CharlieYu4994/superdial/SuperDial电机旋钮屏V2_Bom.xlsx

Sheet: 元器件
SuperDial电机旋钮屏V2物料清单（元器件）
主控板 |  |  |  |  |  |  | 备注
序号 | 数量 | 名称 | 丝印 | 封装 | 值 | 立创链接
1 | 1 | KT-0603R | 3.3 | LED0603-R-RD |  | C2286
2 | 1 | HX25003-2A | B+ GND | CONN-TH_2P-P2.50_HX25003-2A |  | C442299
3 | 3 | CL10A226MQ8NRNC | C1,C6,C8 | C0603 | 22uF | C59461
4 | 5 | CC0603KRX7R9BB104 | C2,C5,C10,C11,C12 | C0603 | 100nF | C14663
5 | 4 | CL21A226MAQNNNE_C45783 | C3,C4,C7,C9 | C0805 | 22uF | C45783 | 耐压25V
6 | 1 | HC-0.8-8PWT | CN2 | CONN-SMD_8P-P0.80_HCTL_HC-0.8-8PWT |  | C2845349
7 | 1 | SWPA6045S100MT | L1 | IND-SMD_L6.0-W6.0_SWPA6045S | 10uH | C79272
8 | 1 | MWSA0402S-1R0MT | L2 | IND-SMD_L4.4-W4.2 | 1uH | C408332
9 | 8 | WS2812B-Mini_C527089 | LED1-LED9 | LED-SMD_4P-L3.5-W3.5-TL_WS2812B |  | C527089 | 3535，可不焊
10 | 8 | 焊盘 | P1,P2,P3,P4,P5,P6,P7,P8 | 焊盘 |  |  | 无需买
11 | 2 | AP2300 | Q1,Q2 | SOT-23-3_L2.9-W1.3-P0.95-LS2.4-BR |  | C360338
12 | 4 | 0603WAF4701T5E | R1,R3,R9,R17 | R0603 | 4.7kΩ | C23162
13 | 9 | 0603WAF1002T5E | R2,R6,R7,R10,R12,R13,R14,R16,R19 | R0603 | 10kΩ | C25804
14 | 1 | 0603WAF200KT5E | R4 | R0603 | 2Ω | C22977
15 | 1 | 1206W4F500LT5E | R5 | R1206 | 500mΩ | C25340
16 | 1 | 0603WAF2202T5E | R8 | R0603 | 22kΩ | C31850
17 | 1 | 0603WAF1003T5E | R11 | R0603 | 100kΩ | C25803
18 | 1 | K2-1107ST-A4DW-06 | SW1 | KEY-SMD_L6.2-W3.6-LS8.0 |  | C118141
19 | 1 | TS-1068A-A2B3-D2 | SW2 | SW-SMD_L6.0-W6.0-LS8.0 |  | C498297 | 160g手感更佳
20 | 1 | ESP32-S3-WROOM-1U-N16R8 | U1 | WIRELM-SMD_ESP32-S3-WROOM-1U |  | C3013946 | 淘宝买建议N16R8
21 | 1 | MT2492 | U2 | SOT-23-6_L2.9-W1.6-P0.95-LS2.8-BR |  | C89358
22 | 1 | IP5306 | U3 | ESOP-8_L4.9-W3.9-P1.27-LS6.0-BL-EP |  | C181692
23 | 1 | KH-TYPE-C-16P | USB1 | USB-C-SMD_KH-TYPE-C-16P |  | C709357
驱动板
序号 | 数量 | 名称 | 丝印 | 封装 | 值 | 立创链接
24 | 3 | CL21A226MAQNNNE_C45783 | C1,C2,C3 | C0805 | 22uF | C45783 | 耐压25V
25 | 1 | CC0603KRX7R9BB104 | C4，C5 | C0603 | 100nF | C14663
26 | 1 | X0800WRS-03HF-LPV01 | CN1 | CONN-SMD_X0800WRS-03HF-LPV01 |  | C500138
27 | 1 | HC-0.8-8PWT | CN2 | CONN-SMD_8P-P0.80_HCTL_HC-0.8-8PWT |  | C2845349
28 | 6 | 1N4148W | D1,D5,D6,D7,D8,D9 | SOD-123F_L2.7-W1.6-LS3.8-RD |  | C81598
29 | 3 | FR107 | D2,D3,D4 | SOD-123FL_L2.7-W1.8-LS3.8-RD |  | C2760867
30 | 6 | AP2300 | Q1,Q2,Q3,Q4,Q5,Q6 | SOT-23-3_L2.9-W1.3-P0.95-LS2.4-BR |  | C360338
31 | 6 | 0603WAF100JT5E | R1,R4,R5,R6,R7,R8 | R0603 | 10Ω | C22859
32 | 2 | 0603WAF4701T5E | R2,R3 | R0603 | 4.7kΩ | C23162
33 | 1 | MT6701CT-STD | U1 | SOP-8_L4.9-W3.9-P1.27-LS6.0-BL |  | C2856764
34 | 1 | EG2133 | U2 | TSSOP-20_L6.5-W4.4-P0.65-LS6.4-BL |  | C190343
屏幕板
序号 | 数量 | 名称 | 丝印 | 封装 | 值 | 立创链接
35 | 1 | CC0603KRX7R9BB104 | C1 | C0603 | 100nF | C14663
36 | 1 | HC-0.8-8PWT | CN2 | CONN-SMD_8P-P0.80_HCTL_HC-0.8-8PWT |  | C2845349
37 | 1 | TFT_1.28_GC9A01_CB1.6-M18 | LCD1 | TFT_1.28_GC9A01_CB1.6-M18 |  |  | 淘宝买
38 | 1 | AP2300 | Q4 | SOT-23-3_L2.9-W1.3-P0.95-LS2.4-BR |  | C360338
39 | 1 | 0603WAF1002T5E | R2 | R0603 | 10kΩ | C25804
40 | 2 | 0603WAF100JT5E | R1,R3 | R0603 | 10Ω | C22859

Sheet: 打印或CNC
SuperDial电机旋钮屏V2物料清单（打印件）
除旋钮外，均不需要添加支撑
旋钮同时支持CNC加工和3D打印
详见stl文件和step文件

Sheet: 其他辅料
SuperDial电机旋钮屏V2物料清单（其他辅料） |  |  |  | 链接
序号 | 数量 | 名称 | 备注
1 | 1 | USB to TTL烧录器 | Wroom32烧录架也兼容
2 | 1 | 杜邦线若干 | 用于连接烧录器和主控
3 | 1 | 直径40mm厚度1mm玻璃 | 屏幕保护
4 | 4 | M2*2大平头螺丝 | 固定转子套
5 | 1 | M2.5*25六角铜柱双通 | 过屏幕线 | https://item.taobao.com/item.htm?spm=a1z09.2.0.0.7b032e8dFfj04J&id=586042823294&_u=e1sddf3s0c59
6 | 1 | 高温结构胶若干 | 固定电机和适配器
7 | 1 | 502胶若干 | 固定铜柱和适配器
8 | 4 | M1.6*4螺丝 | 固定适配器和驱动板
9 | 4 | M2高6.6飞控避震柱 | 套在半牙螺丝外
10 | 4 | M2*12内六角半牙螺丝 | 穿主控、避震柱和驱动，拧到适配器上
11 | 1 | 间距0.8mm 8P 32AWG单头线 | 屏幕线，长度约15cm
12 | 1 | 间距0.8mm 8P 32AWG双头同向线 | 连接驱动和主控，越短越好（可定制）
13 | 3 | M2*5螺丝 | 固定主控和底座
14 | 1 | 3205电机A款 无限位
15 | 1 | 2P杜邦线适量长度 | 连接主控和驱动
16 | 1 | 602535锂电池 600mAh | 可小不可大；不带插头、xh2.54和ph2.0均可（线长50mm）
17 | 1 | 0.15mm双面胶适量 | 固定屏幕
18 | 1 | FPC软天线IPEX 1代 | 贴在底座内壁（高度小于10，长度小于50）
19 | 1 | 直径54mm左右防滑硅胶垫 | 贴在底座底面（定制）
20 | 1 | M2.5*5螺丝 | 可辅助铜柱焊接（不买也行）
21
22
23
24
25
26
27
28
29
30
31
32
33
34
