CharlieYu4994/superdial/3D打印和CNC模型-by虫二/04.转子套.STL

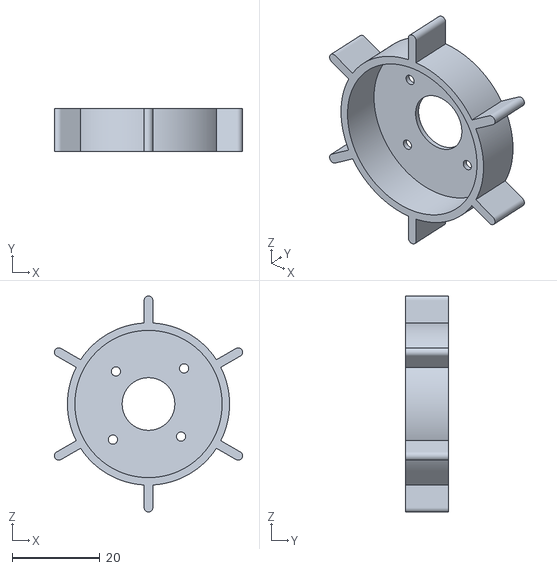
[picture p5: CAD file, 2022-09-06]
3D打印和CNC模型-by虫二/04.转子套.STL
43.0 x 9.80 x 49.3
