CharlieYu4994/superdial/3D打印和CNC模型-by虫二/01.旋钮CNC用.STEP

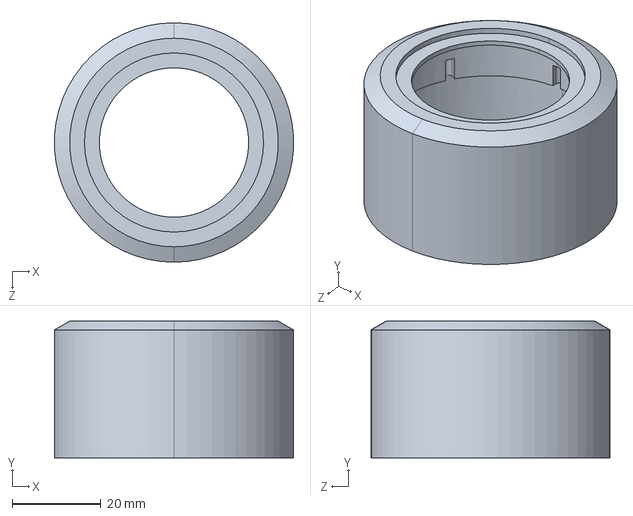
[picture p6: CAD file, 2022-09-06]
3D打印和CNC模型-by虫二/01.旋钮CNC用.STEP
53.9 x 30.9 x 54.0 mm
