CharlieYu4994/superdial/3D打印和CNC模型-by虫二/01.旋钮.STL

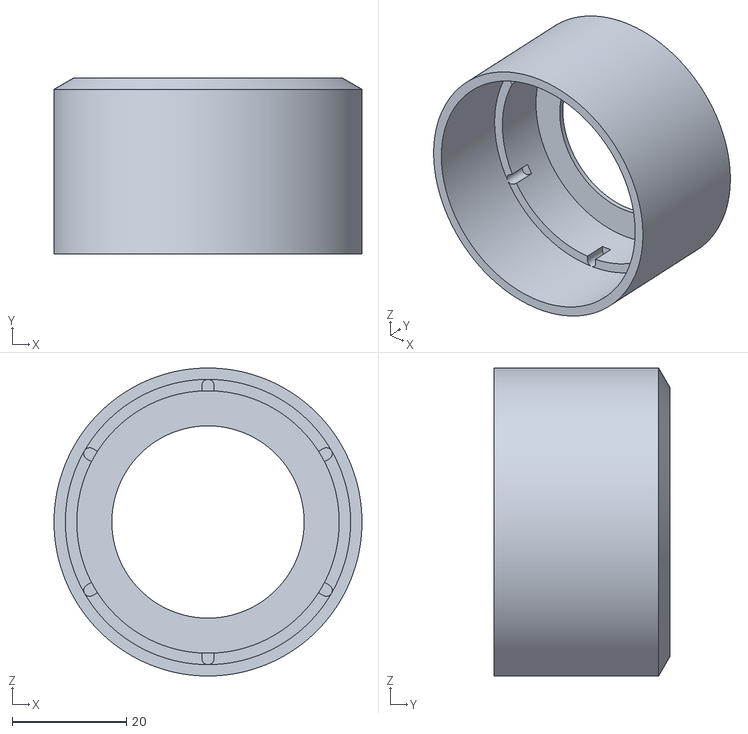
[picture p7: CAD file, 2022-09-06]
3D打印和CNC模型-by虫二/01.旋钮.STL
54.0 x 30.9 x 54.0
