CharlieYu4994/superdial/3D打印和CNC模型-by虫二/03.适配器.STL

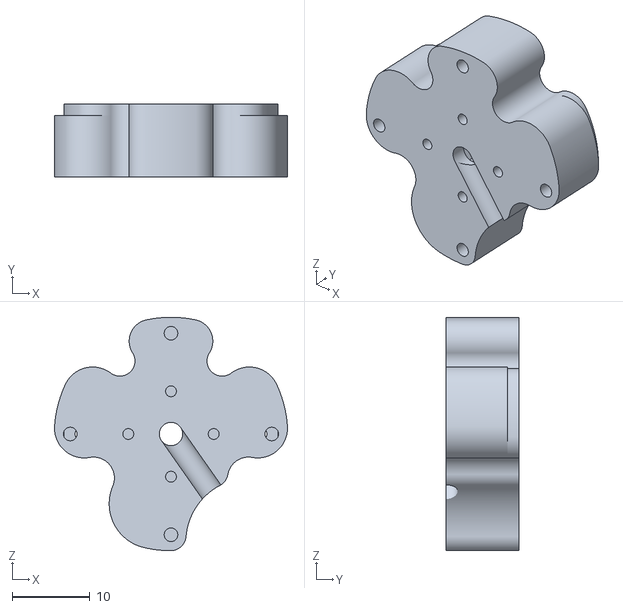
[picture p8: CAD file, 2022-09-06]
3D打印和CNC模型-by虫二/03.适配器.STL
30.0 x 9.40 x 30.1
