CharlieYu4994/superdial/3D打印和CNC模型-by虫二/02.底座.STL

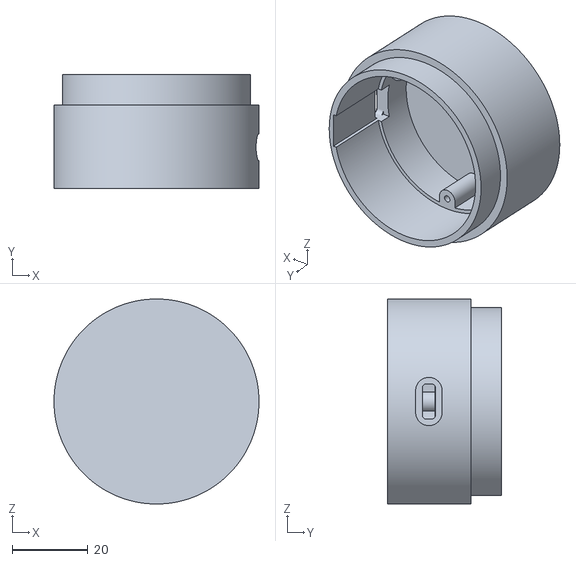
[picture p9: CAD file, 2022-09-06]
3D打印和CNC模型-by虫二/02.底座.STL
54.0 x 30.1 x 54.0
