CharlieYu4994/superdial/(commit log)

2022-09-13 bom修改
    [SuperDial电机旋钮屏V2_Bom.xlsx]
2022-09-14 bom修改，源码上传
    [SuperDial电机旋钮屏V2_Bom.xlsx]
2022-09-20 bin修复屏幕板子不亮问题
2022-11-22 修改mt6701磁编码器 iic -> spi
2022-11-24 修改bin文件，iic -> spi（老版本主控板不支持spi固件），替换力度控制功能为双击关机
